BiergitKraft/RAMPS-FD/README.md

# RAMPS-FD

RAMPS for Due.

A RAMPS style Shield for Arduino Due to benefit from the 32bit uC combined with the modular Design of a RAMPS Board.
V2.3 adds SPI support by simply selecting it with a few jumpers.
V3.0 adds UART support. WIP

Status
-------

V2.3 tested and fuctional.
V3.0 WIP
