BiergitKraft/RAMPS-FD/RAMPS-FD/Docs/RAMPS-FD_bom_v2_3.ods

Component | Description | Part | References | Value | Footprint | Quantity Per PCB | Datasheet | Fitted | Ordering | Price (USD) | Rating | Values | Populate | DriverReference
1 | C0603_100n | 100n | C3 C4 C8 C12 C13 C14 C16 C18 C20 | 100n | C_0603 | 9 |  | yes | LCSC: C85999 | 0,016915 | #100nF #50V #5%
2 | 100uF 35V Elko SMD 6,3x7,7mm | 100u_35V | C2 C5 C6 C7 C9 C10 C11 | 100u_35V | CP_Elec_6.3x7.7 | 7 |  | yes | LCSC: C88675 | 0,067122 | #100uF #35V #20%
3 | C0603_10u | 10u | C15 C17 C19 C21 | 10u | C_0603 | 4 |  | yes | LCSC: C96446 | 0,043979 | #10uF #25V #10%
4 | 1kV 1A General Purpose Diode, SOD-123 | 2CZ4007 | D12 D28 D30 | 2CZ4007 | D_SOD-123F | 3 | https://datasheet.lcsc.com/szlcsc/1809132226_Changjiang-Electronics-Tech-CJ-2CZ4007_C85712.pdf | yes | LCSC: C85712 | 0,05 | #1kV #1A
5 | Schottky Barrier Diode | DS110W | D6 D8 D10 D14 D16 D18 | DS110W | D_SOD-123F | 6 | https://datasheet.lcsc.com/szlcsc/1805300419_Shandong-Jingdao-Microelectronics-DS110W_C123900.pdf | yes | LCSC: C169527 | 0,084347 |  | #100V #1A #850mV
6 | Zener diode | KDZVTR11B | D3 D4 | KDZVTR11B | D_SOD-123F | 2 |  | yes | LCSC: C209598 | 0,09
7 | 530nm GREEN-LED, 0603 | LED_0603_GREEN | D2 D13 | LED_0603_GREEN | LED_0603 | 2 | https://datasheet.lcsc.com/szlcsc/1811141223_TOGIALED-TJ-S1608SW6TGLC2G-A5_C192316.pdf | yes | LCSC: C192316 | 0,021656
8 | 625nm RED-LED, 0603 | LED_0603_RED | D22 D23 D26 D27 D29 D31 | LED_0603_RED | LED_0603 | 6 | https://datasheet.lcsc.com/szlcsc/1811141223_TOGIALED-TJ-S1608SW6TGLC2R-A5_C192315.pdf | yes | LCSC: C192315 | 0,018284
9 | 300V 1A General Purpose Diode, SMA | MRA4003T3G | D5 D20 D21 D24 D25 | MRA4003T3G | D_SMA | 5 | https://www.onsemi.com/pub/Collateral/MRA4003T3-D.PDF | yes | LCSC: C94410 | 0,049228 | #300V #1A
10 | TVS diode | SMF36CA | D7 D9 D11 D15 D17 D19 | SMF36CA | D_SOD-123F | 6 |  | yes | LCSC: C353285 | 0,02
11 | SMD Fuse 750mA Fast | FUSE_750mA_0603 | F5 F6 | FUSE_750mA_0603 | R_0603 | 2 |  | Fitted | LCSC: C310926 | 0,07 | #32V #750mA
12 | Blade Fuse Holder for Car Fuses | Keystone_3568 | F2 F3 F4 | Keystone_3568 | Fuseholder_Blade_Mini_Keystone_3568 | 3 |  | yes | Digikey: 36-3568-ND | 1,03 | #500V #30A
13 | Ferrite Bed 0603 | FB0603 | FB2 | FB0603 | R_0603 | 1 | ~ | yes | LCSC: C441755 | 0,032936 | #500mA #390Ohm@100MHz
14 |  | 1x18PinHeader | J24 | 1x18PinHeader | PinHeader_1x18_P2.54mm_Vertical | 1 |  | yes | LCSC: 1xC124381 1xC124372 | 0,095805
15 |  | 1x3JumperArray | J5 J7 | 1x3JumperArray | PinHeader_1x03_P2.54mm_Vertical | 2 |  | yes | LCSC: C49257 | 0,010025
16 |  | 1x3PinHeader | J8 J17 J20 | 1x3PinHeader | PinHeader_1x03_P2.54mm_Vertical | 3 |  | yes | LCSC: C49257 | 0,010025
17 |  | 1x4PinHeader | J9 J10 J11 J12 J14 J15 J16 J19 J22 | 1x4PinHeader | pin_header_2.54mm_1x4 | 9 |  | yes | LCSC: C124378 | 0,024235
18 | 2 Circuit Screw Terminal P3.50 | 2_PinScrewTerminal_P350 | J25 J27 J28 | 2_PinScrewTerminal_P350 | 2x1_P350 | 3 |  | yes | LCSC: C474892 | 0,07
19 | 2 Circuit Screw Terminal P5.08 | 2_PinScrewTerminal_P508 | J26 | 2_PinScrewTerminal_P508 | 2x1_P508 | 1 |  | yes | LCSC: C474952 | 0,13895
20 |  | 2x1PinHeader | J2 J6 J13 J30 J31 | 2x1PinHeader | PinHeader_1x02_P2.54mm_Vertical | 5 |  | yes | LCSC: C124375 | 0,015147
21 | 2x4 Pin Header 2.54mm | 2x4PinHeader_2.54mm | J32 | 2x4PinHeader_2.54mm | pin_header_2.54mm_2x4 | 1 |  | yes | LCSC: C124386 | 0,039494
22 |  | 2x5PinHeader | J18 | 2x5PinHeader | pin_header_2.54mm_2x5 | 1 |  | yes | LCSC: C124387 | 0,04557
23 |  | 2x6PinHeader | J21 | 2x6PinHeader | pin_header_2.54mm_2x6 | 1 |  | yes | LCSC: C124388 | 0,057859
24 |  | 3x4PinHeader | J23 | 3x4PinHeader | 4x3_2.54mm_Header | 1 |  | yes | LCSC: 1x C124386 1xC124378 | 0,063729
25 |  | 3x6PinHeader | J29 | 3x6PinHeader | 6x3_2.54mm_Header | 1 |  | yes | LCSC: 3xC190819 | 0,07
26 | 6 Circuit Screw Terminal P5.08 | 6_PinScrewPlugableTerminal_P508 | J3 | 6_PinScrewPlugableTerminal_P508 | 6x1_P508_RA | 1 |  | yes | LCSC: 1xC71374 1xC8435 | 0,427717
27 |  | NetTie_1mm | J4 | NetTie_1mm | TIE-1MM | 1 |  |  |  |  |  |  | No
28 | Generic connector, single row, 01x02, script generated (kicad-library-utils/schlib/autogen/connector/) | 1x2JumperArray | JP2 JP3 JP5 JP7 JP9 JP11 JP13 JP15 JP16 | 1x2JumperArray | PinHeader_1x02_P2.54mm_Vertical | 9 | ~ | yes | LCSC: C124375 | 0,015147
29 |  | 4x3JumperArray | JP4 JP6 JP8 JP10 JP12 JP14 | 4x3JumperArray | 4x3_2.54mm_Header | 6 |  | yes | LCSC: 1x C124386 1xC124378 | 0,063729
30 |  | LOGO_OSHW | M2 | LOGO_OSHW | OSHW_logo_2 | 1 |  |  |  |  |  |  | No
31 | N Channel MOSFET | NCE3416 | Q2 Q5 Q10 Q11 | NCE3416 | SOT-23 | 4 | https://datasheet.lcsc.com/szlcsc/1811071721_Wuxi-NCE-Power-Semiconductor-NCE3416_C113491.pdf | yes | LCSC: C113491 | 0,033091 | #20V #6.5A
32 | N Channel Power MOSFET | PSMN1R8-40YLC | Q7 | PSMN1R8-40YLC | LFPAK56 | 1 | https://assets.nexperia.com/documents/data-sheet/PSMN1R8-40YLC.pdf | yes | LCSC: C124522 | 0,281273 | #40V #100A
33 | N Channel Power MOSFET | PSMN7R5-60YLX | Q6 Q8 Q9 | PSMN7R5-60YLX | LFPAK56 | 3 | https://assets.nexperia.com/documents/data-sheet/PSMN1R8-40YLC.pdf | yes | LCSC: C478175 | 0,972045 | #60V #86A
34 | -17A Id, -30V Vds, P-Channel MOSFET, SO 8 | TDM3415 | Q3 Q4 | TDM3415 | SO-8_3.9x4.9mm_P1.27mm | 2 | https://datasheet.lcsc.com/szlcsc/1912111437_APEC-Advanced-Power-Elec-AP4439GM_C429862.pdf | yes | LCSC: C189490 | 0,26
35 | R0603_100k | 100k | R7 R9 R11 R12 R17 R19 R21 | 100k | R_0603 | 7 |  | yes | LCSC: C237792 | 0,003527
36 | R0603_10k | 10k | R3 R4 R6 R8 R10 R16 R18 R20 R22 R23 R24 R25 | 10k | R_0603 | 12 |  | yes | LCSC: C238881 | 0,003395
37 | R0603_1k0 | 1k | R5 R15 R26 R27 R30 R31 R34 R36 R38 R39 R40 R41 | 1k | R_0603 | 12 |  | yes | LCSC: C328340 | 0,003087
38 | R0603_330R | 330R | R2 R14 | 330R | R_0603 | 2 |  | yes | LCSC: C144606 | 0,002275
39 | R0603_33R | 33R | R28 R29 R32 R33 R35 R37 | 33R | R_0603 | 6 |  | yes | LCSC: C325638 | 0,002066
40 | R0603_4k7 | 4k7 | R13 | 4k7 | R_0603 | 1 |  | yes | LCSC: C137710 | 0,002446
41 | 10k 0603 x4 Array | 10kArrayx4 | RP2 RP3 RP4 RP5 RP6 | 10kArrayx4 | R_Array_Convex_4x0603 | 5 |  | yes | LCSC: C29718 | 0,007304
42 |  | ARDUINO_DUE_SHIELD | SHIELD2 | ARDUINO_DUE_SHIELD | ARDUINO_MEGA_DUE_SHIELD_FOOTPRINT_RMC | 1 |  | yes | LCSC: 1xC124372 5xC124381 1xC168945
43 |  | PushButton | SW2 | PushButton | SW_6x6_SMD | 1 |  | yes | LCSC: C273496 | 0,497955
44 | Non-Volatile 512Kb (64K x 8) I2C EEPROM | 24C512 | U10 | 24C512 | SOIC-8_3.9x4.9mm_P1.27mm | 1 |  | yes | LCSC: C79986 | 0,295782
45 | Fixed 32V 12V 1A TO-252-2(DPAK) Linear Voltage Regulator | AS7812ADTR | U2 | AS7812ADTR | TO-252-2 | 1 |  | yes | LCSC: C248312 | 0,203382 | #12V #35V #1A
46 | Low Voltage Hex Buffer with Open Drain Outputs | MC74LCX07 | U11 | MC74LCX07 | TSSOP-14_4.4x5mm_P0.65mm | 1 | https://www.onsemi.com/pub/Collateral/MC74LCX07-D.PDF | yes | LCSC: C233625 | 0,171882
47 | Header for Motor Driver | Pololu | U3 U4 U5 U7 U8 U9 | Pololu | POLOLU | 6 |  | yes | LCSC: 2x C27438 | 0,102 |  |  |  | ?
48 | Single Power Supply Single Buffer Gate | SN74LV1T125 | U6 | SN74LV1T125 | SOT-23-5 | 1 | https://www.ti.com/lit/ds/symlink/sn74lv1t125.pdf | yes | LCSC: C473338 | 0,268864
49 | R0603_33V | 33V | VR2 VR3 VR4 VR5 VR6 VR7 VR8 VR9 VR10 VR11 VR12 VR13 VR14 VR15 VR16 VR17 VR18 VR19 VR20 VR21 VR22 VR23 VR24 VR25 VR26 VR27 VR28 VR29 VR30 VR31 VR32 VR33 VR34 VR35 VR36 VR37 | 33V | R_0603 | 36 |  | yes | LCSC: C336820 | 0,08
 |  |  |  |  |  |  |  |  |  | 5,932273
Component Groups: | 49
Component Count: | 206
Fitted Components: | 206
Number of PCBs: | 1
Total components: | 206
Schematic Version: | v2.3
Schematic Date: | 2019-04-13
PCB Variant: | ['default']
BoM Date: | Di 26 Mai 2020 21:52:22 CEST
Schematic Source: | RAMPS-FD.sch
KiCad Version: | Eeschema 5.1.5
