BiergitKraft/RAMPS-FD/RAMPS-FD/Docs/Bestückungsdruck.pdf

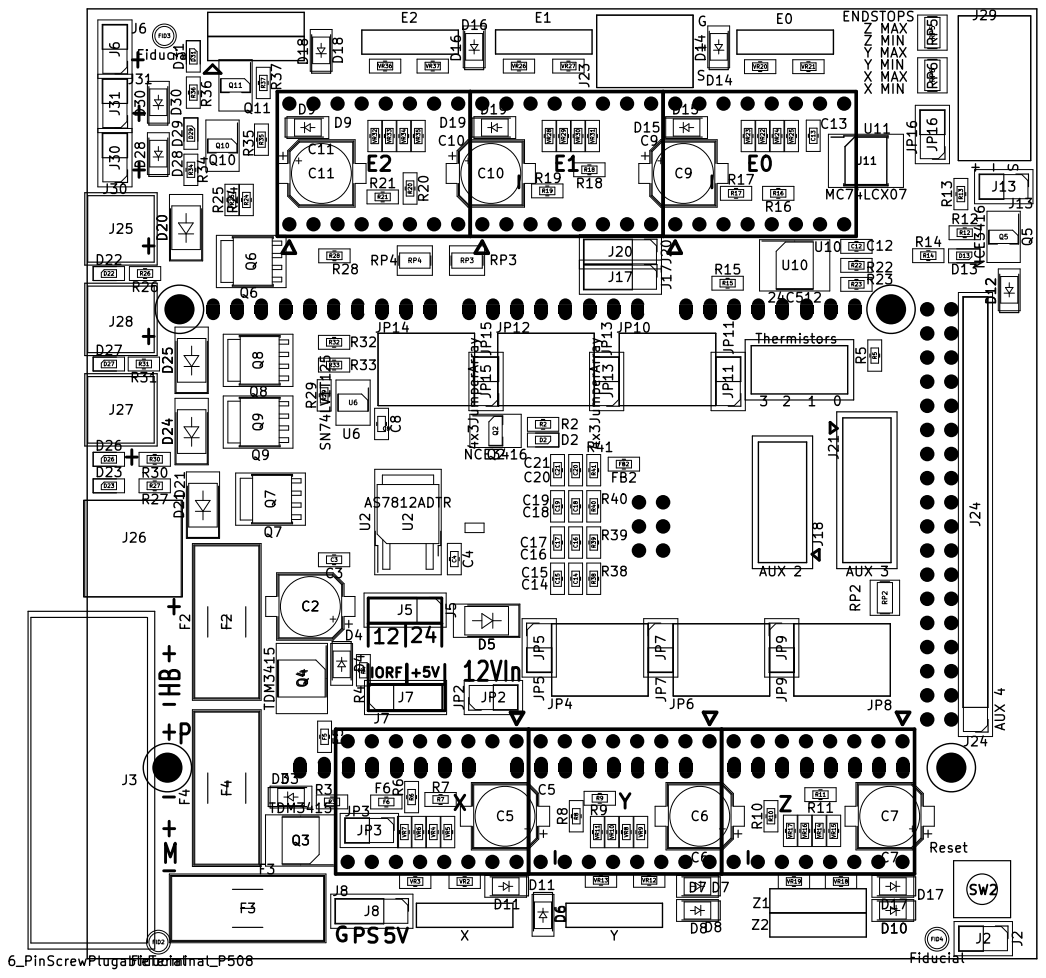
[picture p2: page 1]
