BiergitKraft/RAMPS-FD/RAMPS-FD/RAMPS-FD-gerbers/RAMPS-FD-F_Fab.pdf

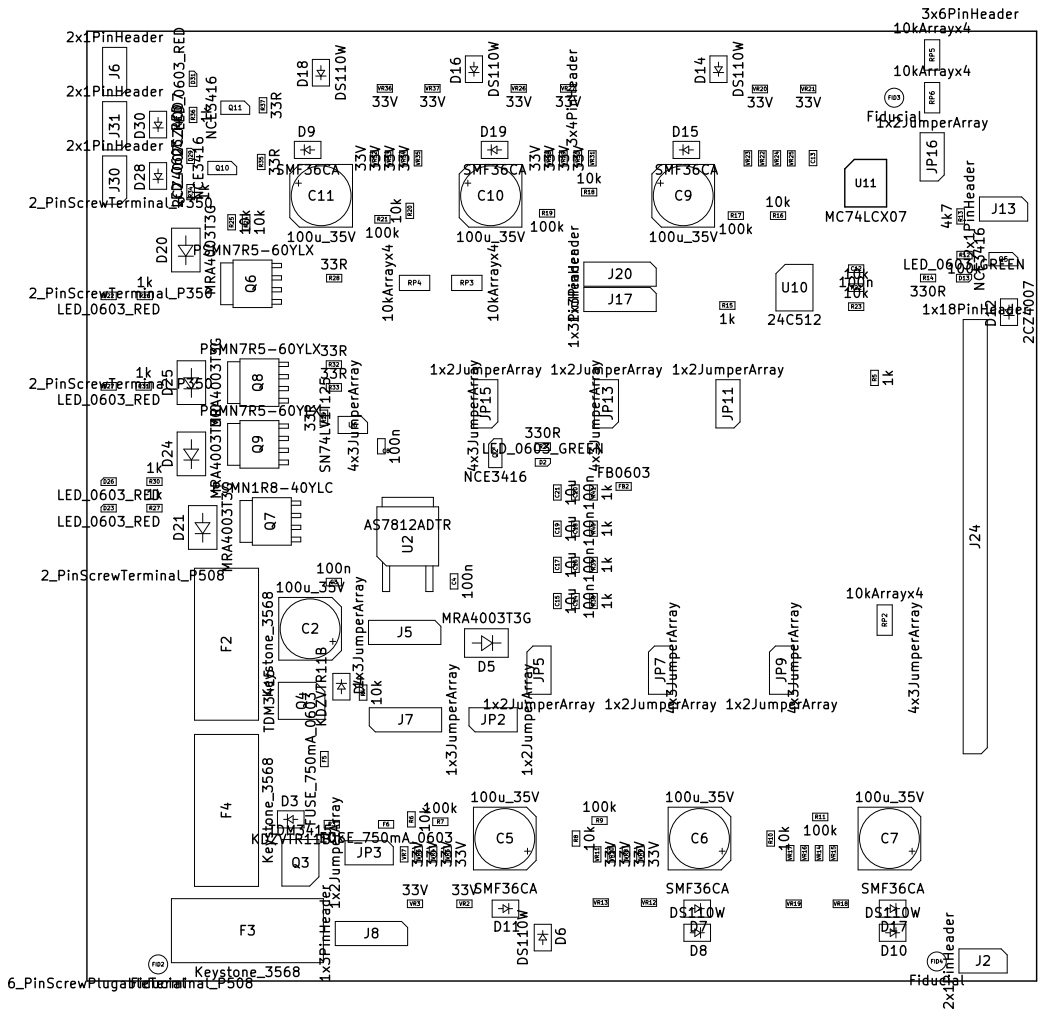
[picture p13: page 1]
