BiergitKraft/RAMPS-FD/RAMPS-FD/RAMPS-FD-gerbers/Bestückplan.pdf

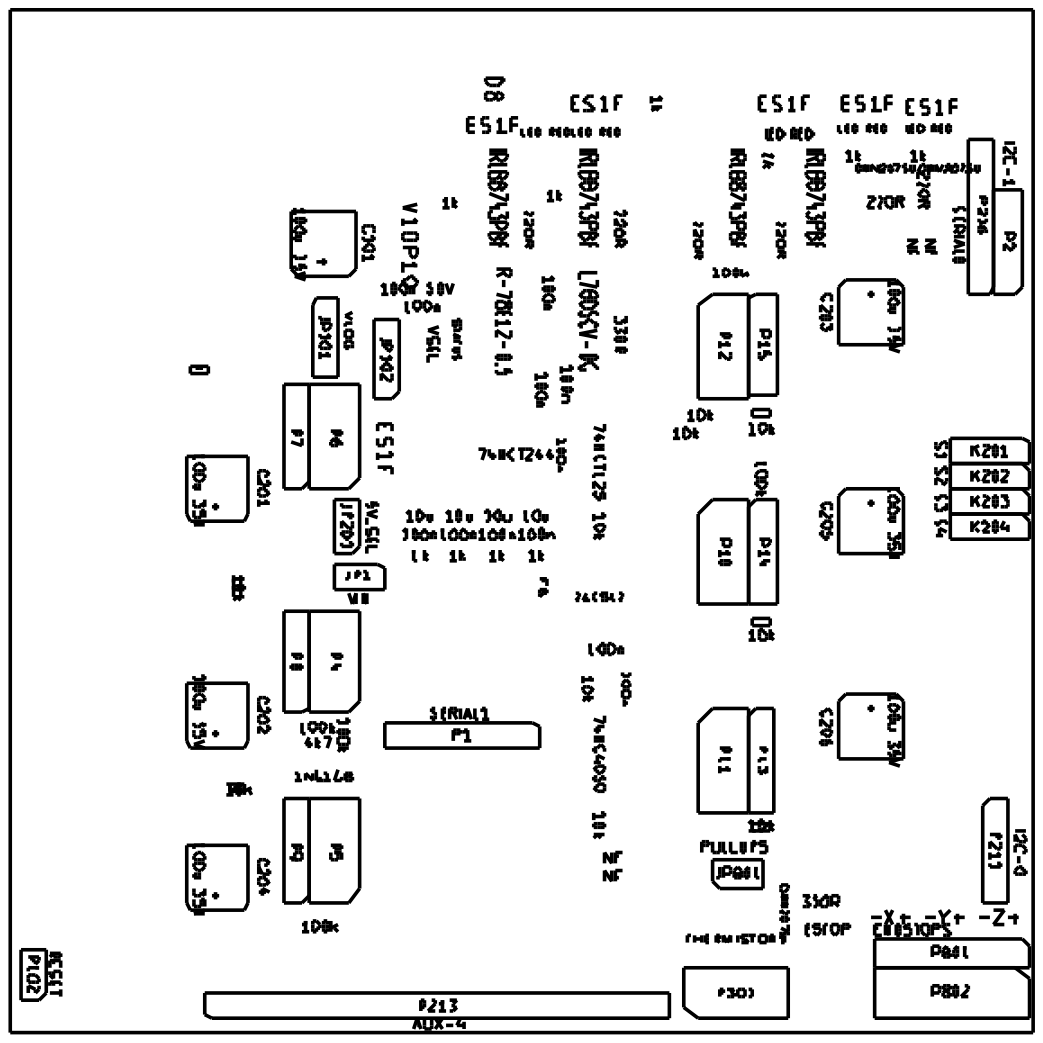
[picture p14: page 1]

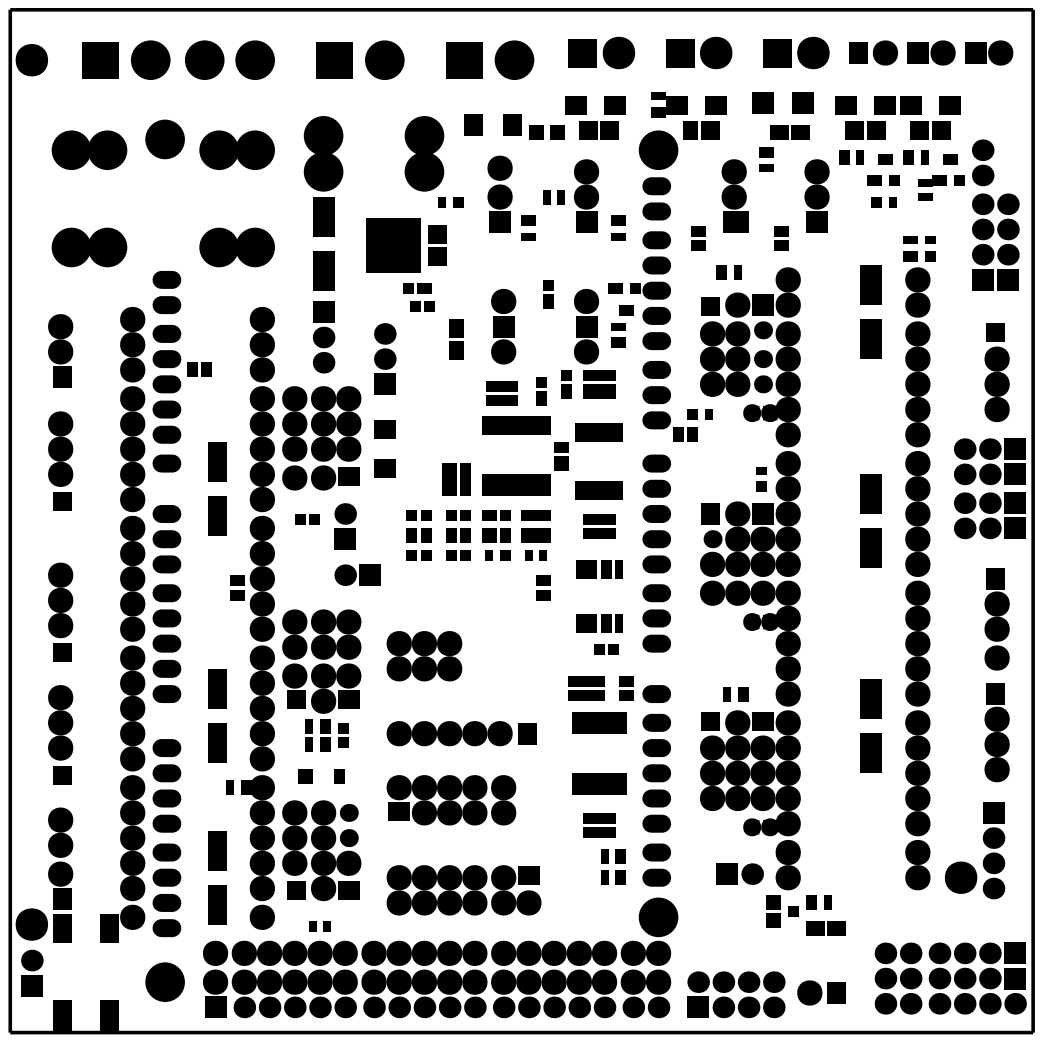
[picture p15: page 2]
