BiergitKraft/RAMPS-FD/RAMPS-FD/RAMPS-FD.kicad_pcb

## KiCad design RAMPS-FD/RAMPS-FD.kicad_pcb (2020-08-26)

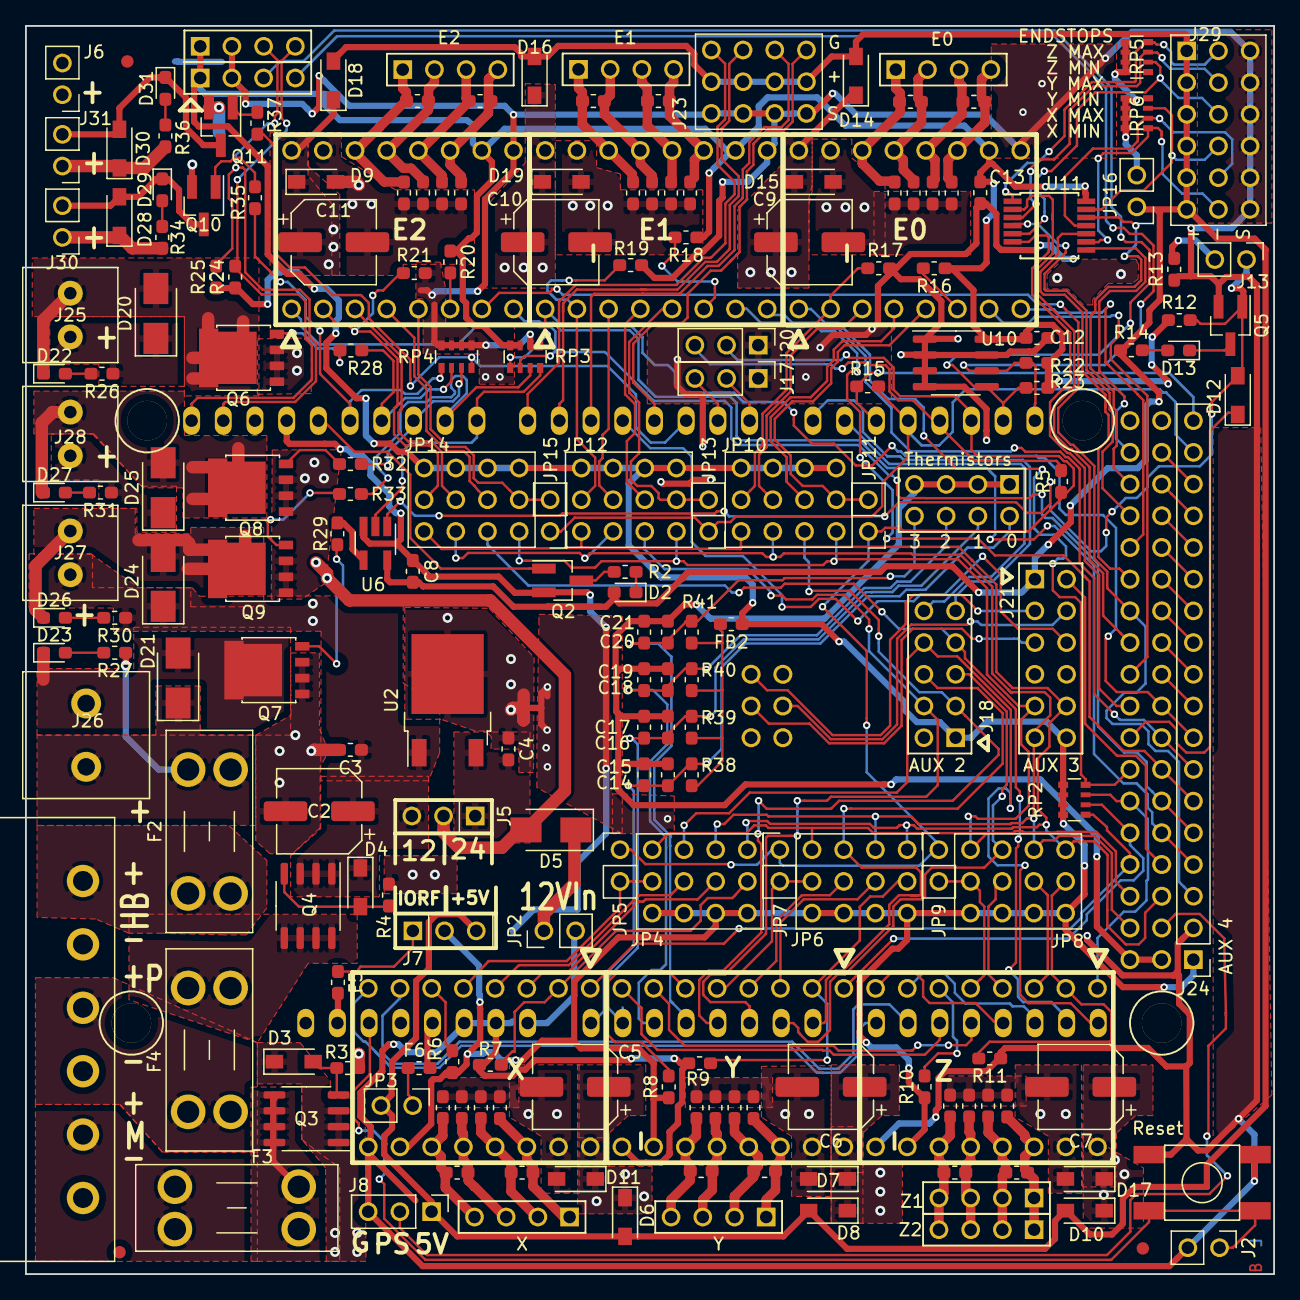
[picture p16: board RAMPS-FD.kicad_pcb from above]

Board: 2 copper layers, 100.0 x 100.0 mm, 209 parts (1 on the bottom side), 186 nets.

Parts:
C2, C5, C6, C7, C9, C10, C11: 100u_35V; CP_Elec_6.3x7.7
C3, C4, C8, C12, C13, C14, C16, C18, C20: 100n; C_0603
C15, C17, C19, C21: 10u; C_0603
D2, D13: LED_0603_GREEN; LED_0603
D3, D4: KDZVTR11B; D_SOD-123F
D5, D20, D21, D24, D25: MRA4003T3G; D_SMA
D6, D8, D10, D14, D16, D18: DS110W; D_SOD-123F
D7, D9, D11, D15, D17, D19: SMF36CA; D_SOD-123F
D12, D28, D30: 2CZ4007; D_SOD-123F
D22, D23, D26, D27, D29, D31: LED_0603_RED; LED_0603
F2, F3, F4: Keystone_3568; Fuseholder_Blade_Mini_Keystone_3568
F5, F6: FUSE_750mA_0603; R_0603
FB2: FB0603; R_0603
FID2, FID3, FID4: Fiducial; Fiducial_1mm_Mask2mm
J2, J6, J13, J30, J31: 2x1PinHeader; PinHeader_1x02_P2.54mm_Vertical
J3: 6_PinScrewPlugableTerminal_P508; 6x1_P508_RA
J5, J7: 1x3JumperArray; PinHeader_1x03_P2.54mm_Vertical
J8, J17, J20: 1x3PinHeader; PinHeader_1x03_P2.54mm_Vertical
J9, J10, J11, J12, J14, J15, J16, J19, J22: 1x4PinHeader; pin_header_2.54mm_1x4
J18: 2x5PinHeader; pin_header_2.54mm_2x5
J21: 2x6PinHeader; pin_header_2.54mm_2x6
J23: 3x4PinHeader; 4x3_2.54mm_Header
J24: 1x18PinHeader; PinHeader_1x18_P2.54mm_Vertical
J25, J27, J28: 2_PinScrewTerminal_P350; 2x1_P350
J26: 2_PinScrewTerminal_P508; 2x1_P508
J29: 3x6PinHeader; 6x3_2.54mm_Header
J32: 2x4PinHeader_2.54mm; pin_header_2.54mm_2x4
JP2, JP3, JP5, JP7, JP9, JP11, JP13, JP15, JP16: 1x2JumperArray; PinHeader_1x02_P2.54mm_Vertical
JP4, JP6, JP8, JP10, JP12, JP14: 4x3JumperArray; 4x3_2.54mm_Header
M2: LOGO_OSHW; OSHW_logo_2
NT1: NetTie-2_SMD_Pad0.5mm
Q2, Q5, Q10, Q11: NCE3416; SOT-23
Q3, Q4: TDM3415; SO-8_3.9x4.9mm_P1.27mm
Q6, Q8, Q9: PSMN7R5-60YLX; LFPAK56
Q7: PSMN1R8-40YLC; LFPAK56
R2, R14: 330R; R_0603
R3, R4, R6, R8, R10, R16, R18, R20, R22, R23, R24, R25: 10k; R_0603
R5, R15, R26, R27, R30, R31, R34, R36, R38, R39, R40, R41: 1k; R_0603
R7, R9, R11, R12, R17, R19, R21: 100k; R_0603
R13: 4k7; R_0603
R28, R29, R32, R33, R35, R37: 33R; R_0603
RP2, RP3, RP4, RP5, RP6: 10kArrayx4; R_Array_Convex_4x0603
SHIELD2: ARDUINO_DUE_SHIELD; ARDUINO_MEGA_DUE_SHIELD_FOOTPRINT_RMC
SW2: PushButton; SW_6x6_SMD
U2: AS7812ADTR; TO-252-2
U3, U4, U5, U7, U8, U9: Pololu; POLOLU
U6: SN74LV1T125; SOT-23-5
U10: 24C512; SOIC-8_3.9x4.9mm_P1.27mm
U11: MC74LCX07; TSSOP-14_4.4x5mm_P0.65mm
VR2, VR3, VR4, VR5, VR6, VR7, VR8, VR9, VR10, VR11, VR12, VR13, VR14, VR15, VR16, VR17, VR18, VR19, VR20, VR21, VR22, VR23, VR24, VR25, VR26, VR27, VR28, VR29, VR30, VR31, VR32, VR33, VR34, VR35, VR36, VR37: 33V; R_0603

Connections:
+5V: C8.1, D2.2, D6.2, D8.2, D10.2, D14.2, D16.2, D18.2, J7.3, J8.1, J21.1, J23.2, J23.5, J23.8, J23.11, J29.1, J29.4, J29.7, J29.10, J29.13, J29.16, JP3.2, JP16.1, R14.1, U6.5
+12P: D5.2, D28.1, D30.1, J5.2, J6.1, J30.1, J31.1, R34.1, R36.1
+V_HEATBED: D21.1, F2.2, J26.1, R27.1
+V_LOGIC: C12.1, C13.1, FB2.1, J7.2, J18.1, J19.1, J21.12, J22.1, J24.1, JP4.3, JP4.6, JP4.9, JP4.12, JP6.3, JP6.6, JP6.9, JP6.12, JP8.3, JP8.6, JP8.9, JP8.12, JP10.3, JP10.6, JP10.9, JP10.12, JP12.3, JP12.6, JP12.9, JP12.12, JP14.3, JP14.6, JP14.9, JP14.12, R6.1, R8.1, R10.1, R12.1, R16.1, R18.1, R20.1, R22.1, R23.1, R24.1, R25.1, RP2.5, RP2.6, RP2.7, RP2.8, RP3.7, RP3.8, U3.10, U4.10, U5.10, U7.10, U8.10, U9.10, U10.8, U11.14
+V_MOTOR: C5.1, C6.1, C7.1, C9.1, C10.1, C11.1, D3.1, D6.1, D7.1, D8.1, D9.1, D10.1, D11.1, D14.1, D15.1, D16.1, D17.1, D18.1, D19.1, Q3.1, Q3.2, Q3.3, U3.16, U4.16, U5.16, U7.16, U8.16, U9.16
+V_POWER: C2.1, C3.1, D4.1, D20.1, D24.1, D25.1, J5.3, J25.1, J27.1, J28.1, Q4.1, Q4.2, Q4.3, R26.1, R30.1, R31.1, U2.1
/E0_EN_BUF: RP2.4, SHIELD2.42, U7.1
/E1_EN_BUF: J24.8, RP3.1, SHIELD2.39, U8.1
/E2_EN_BUF: J24.5, RP3.2, SHIELD2.45, U9.1
/Extra MOSFETs/P_FET5: D28.2, D29.1, J30.2, Q10.3
/Extra MOSFETs/P_FET6: D30.2, D31.1, J31.2, Q11.3
/Mosfet Outputs/D8_OUT: D21.2, D23.1, J26.2, Q7.5
/Mosfet Outputs/D9_OUT: D24.2, D26.1, J27.2, Q9.5
/Mosfet Outputs/D10_OUT: D25.2, D27.1, J28.2, Q8.5
/Mosfet Outputs/FET4_OUT: D20.2, D22.1, J25.2, Q6.5
/Power/HB_IN: F2.1, J3.1
/Power/LP_1: D5.1, JP2.1
/Power/LP_2: C4.1, J5.1, U2.3
/Power/MOT_IN: F3.1, J3.5
/Power/P_IN: F4.1, J3.3
/RESET: J2.1, SHIELD2.RST, SW2.1
/Stepper Drivers 2/E0-1A: J14.3, U7.12, VR21.1, VR24.1
/Stepper Drivers 2/E0-1B: J14.4, U7.11, VR21.2, VR25.1
/Stepper Drivers 2/E0-2A: J14.2, U7.13, VR20.2, VR22.1
/Stepper Drivers 2/E0-2B: J14.1, U7.14, VR20.1, VR23.1
/Stepper Drivers 2/E1-1A: J15.3, U8.12, VR27.1, VR30.1
/Stepper Drivers 2/E1-1B: J15.4, U8.11, VR27.2, VR31.1
/Stepper Drivers 2/E1-2A: J15.2, U8.13, VR26.2, VR29.1
/Stepper Drivers 2/E1-2B: J15.1, U8.14, VR26.1, VR28.1
/Stepper Drivers 2/E2-1A: J16.3, U9.12, VR34.1, VR37.1
/Stepper Drivers 2/E2-1B: J16.4, U9.11, VR35.1, VR37.2
/Stepper Drivers 2/E2-2A: J16.2, U9.13, VR33.1, VR36.2
/Stepper Drivers 2/E2-2B: J16.1, U9.14, VR32.1, VR36.1
/Stepper Drivers/X-1A: J9.3, U3.12, VR3.1, VR6.1
/Stepper Drivers/X-1B: J9.4, U3.11, VR3.2, VR7.1
/Stepper Drivers/X-2A: J9.2, U3.13, VR2.2, VR4.1
/Stepper Drivers/X-2B: J9.1, U3.14, VR2.1, VR5.1
/Stepper Drivers/Y-1A: J10.3, U4.12, VR10.1, VR13.1
/Stepper Drivers/Y-1B: J10.4, U4.11, VR11.1, VR13.2
/Stepper Drivers/Y-2A: J10.2, U4.13, VR8.1, VR12.2
/Stepper Drivers/Y-2B: J10.1, U4.14, VR9.1, VR12.1
/Stepper Drivers/Z-1A: J11.3, J12.3, U5.12, VR16.1, VR19.1
/Stepper Drivers/Z-1B: J11.4, J12.4, U5.11, VR17.1, VR19.2
/Stepper Drivers/Z-2A: J11.2, J12.2, U5.13, VR14.1, VR18.2
/Stepper Drivers/Z-2B: J11.1, J12.1, U5.14, VR15.1, VR18.1
/X_EN_BUF: RP2.1, SHIELD2.48, U3.1
/Y_EN_BUF: RP2.2, SHIELD2.46, U4.1
/Z_EN_BUF: RP2.3, SHIELD2.44, U5.1
A4: J18.3, JP10.7, SHIELD2.AD4
A5: J18.4, JP12.7, SHIELD2.AD5
A6: J18.5, JP8.7, SHIELD2.AD6
A7: J18.6, JP6.7, SHIELD2.AD7
AD14: J18.7, JP14.7, SHIELD2.AD14
AD15: J18.8, JP4.7, SHIELD2.AD15
AM-VIN: JP2.2, SHIELD2.V_IN
AREF: FB2.2, R38.1, R39.1, R40.1, R41.1
D2-FET6: R37.1, RP4.8, SHIELD2.2
D8: RP3.4, SHIELD2.8, U6.2
D8_BUF: R29.1, U6.4
D9: R33.1, RP3.3, SHIELD2.9
D10: R32.1, RP4.7, SHIELD2.10
D11-FET4: R28.1, RP4.6, SHIELD2.11
D12-FET5: R35.1, RP4.5, SHIELD2.12
D13: Q2.1, SHIELD2.13
D23: J24.16, SHIELD2.23
D25: J24.15, SHIELD2.25
D27: J24.14, SHIELD2.27
D29: J24.13, SHIELD2.29
D31: J24.12, SHIELD2.31
D32: J24.3, SHIELD2.32, U9.7
D33: J24.11, SHIELD2.33
D35: J24.10, SHIELD2.35
D37: J24.9, SHIELD2.37
D41: J24.7, SHIELD2.41, U8.8
D43: J24.6, SHIELD2.43, U8.7
D47: J24.4, SHIELD2.47, U9.8
D49: J21.2, SHIELD2.49
D50-MISO: J21.9, JP4.10, JP6.10, JP8.10, JP10.10, JP12.10, JP14.10, SHIELD2.50
D51-MOSI: J21.10, JP4.1, JP6.1, JP8.1, JP10.1, JP12.1, JP14.1, SHIELD2.51
D52-SCK: J21.11, JP4.4, JP6.4, JP8.4, JP10.4, JP12.4, JP14.4, SHIELD2.52
DUE_5V: F6.2, SHIELD2.5V
E0_DIR: SHIELD2.28, U7.8
E0_STEP: SHIELD2.36, U7.7
ESTOP: D12.1, SHIELD2.40
GND: C8.2, C12.2, C13.2, J2.2, J6.2, J8.3, J17.1, J18.2, J19.2, J20.1, J21.7, J22.2, J23.1, J23.4, J23.7, J23.10, J24.2, J29.3, J29.6, J29.9, J29.12, J29.15, J29.18, NT1.2, Q2.2, Q5.2, R7.2, R9.2, R11.2, R13.2, R17.2, R19.2, R21.2, RP3.5, RP3.6, RP4.1, RP4.2, RP4.3, RP4.4, SHIELD2.GND, SHIELD2.GND6, SW2.2, U3.9, U4.9, U5.9, U6.3, U7.9, U8.9, U9.9, U10.1, U10.2, U10.3, U10.4, U10.7, U11.7
GNDA: C14.2, C15.2, C16.2, C17.2, C18.2, C19.2, C20.2, C21.2, J32.1, J32.3, J32.5, J32.7, SHIELD2.GND4, SHIELD2.GND5
IOREF: F5.2, SHIELD2.IORF
MISO: J21.3, SHIELD2.MISO
MOSI: J21.4, SHIELD2.MOSI
MOT_GND: C2.2, C3.2, C4.2, C5.2, C6.2, C7.2, C9.2, C10.2, C11.2, D7.2, D9.2, D11.2, D15.2, D17.2, D19.2, J3.2, J3.4, J3.6, NT1.1, Q6.1, Q6.2, Q6.3, Q7.1, Q7.2, Q7.3, Q8.1, Q8.2, Q8.3, Q9.1, Q9.2, Q9.3, Q10.2, Q11.2, R3.2, R4.2, U2.2, U3.15, U4.15, U5.15, U7.15, U8.15, U9.15, VR4.2, VR5.2, VR6.2, VR7.2, VR8.2, VR9.2, VR10.2, VR11.2, VR14.2, VR15.2, VR16.2, VR17.2, VR22.2, VR23.2, VR24.2, VR25.2, VR28.2, VR29.2, VR30.2, VR31.2, VR32.2, VR33.2, VR34.2, VR35.2
unnamed: D2.1, R2.1
unnamed: D3.2, Q3.4, R3.1
unnamed: D4.2, Q4.4, R4.1
unnamed: D12.2, J13.1, Q5.1, R12.2, U6.1
unnamed: D13.1, Q5.3
unnamed: D13.2, R14.2
unnamed: D22.2, R26.2
unnamed: D23.2, R27.2
unnamed: D26.2, R30.2
unnamed: D27.2, R31.2
unnamed: D29.2, R34.2
unnamed: D31.2, R36.2
unnamed: F3.2, Q3.5, Q3.6, Q3.7, Q3.8
unnamed: F4.2, Q4.5, Q4.6, Q4.7, Q4.8
unnamed: F5.1, J7.1
unnamed: F6.1, JP3.1
unnamed: J13.2, R13.1
unnamed: J29.2, RP5.4, U11.1
unnamed: J29.5, RP5.3, U11.3
unnamed: J29.8, RP5.2, U11.5
unnamed: J29.11, RP6.3, U11.13
unnamed: J29.14, RP6.2, U11.11
unnamed: J29.17, RP6.1, U11.9
unnamed: JP4.2, R7.1, U3.2
unnamed: JP4.5, U3.3
unnamed: JP4.8, U3.4
unnamed: JP4.11, JP5.2, U3.5
unnamed: JP6.2, R9.1, U4.2
unnamed: JP6.5, U4.3
unnamed: JP6.8, U4.4
unnamed: JP6.11, JP7.2, U4.5
unnamed: JP8.2, R11.1, U5.2
unnamed: JP8.5, U5.3
unnamed: JP8.8, U5.4
unnamed: JP8.11, JP9.2, U5.5
unnamed: JP10.2, R17.1, U7.2
unnamed: JP10.5, U7.3
unnamed: JP10.8, U7.4
unnamed: JP10.11, JP11.2, U7.5
unnamed: JP12.2, R19.1, U8.2
unnamed: JP12.5, U8.3
unnamed: JP12.8, U8.4
unnamed: JP12.11, JP13.2, U8.5
unnamed: JP14.2, R21.1, U9.2
unnamed: JP14.5, U9.3
unnamed: JP14.8, U9.4
unnamed: JP14.11, JP15.2, U9.5
unnamed: JP16.2, RP5.5, RP5.6, RP5.7, RP5.8, RP6.5, RP6.6, RP6.7, RP6.8
unnamed: Q2.3, R2.2
unnamed: Q6.4, R28.2
unnamed: Q7.4, R29.2
unnamed: Q8.4, R32.2
unnamed: Q9.4, R33.2
unnamed: Q10.1, R35.2
unnamed: Q11.1, R37.2
unnamed: R6.2, U3.6
unnamed: R8.2, U4.6
unnamed: R10.2, U5.6
unnamed: R16.2, U7.6
unnamed: R18.2, U8.6
unnamed: R20.2, U9.6
PS-ON: J8.2, SHIELD2.53
SCK: J21.5, SHIELD2.SCK
SCL: J19.4, R22.2, SHIELD2.21, U10.6
SCL1: J22.4, R24.2, SHIELD2.SCL1
SDA: J19.3, R23.2, SHIELD2.20, U10.5
SDA1: J22.3, R25.2, SHIELD2.SDA1
SERVO1: J23.3, SHIELD2.7
SERVO2: J23.6, SHIELD2.6
SERVO3: J23.9, SHIELD2.5
SERVO4: J23.12, SHIELD2.3
SPI_CS1: J21.6, SHIELD2.4
THERM0: C14.1, C15.1, J32.2, R38.2, SHIELD2.AD0
THERM1: C16.1, C17.1, J32.4, R39.2, SHIELD2.AD1
THERM2: C18.1, C19.1, J32.6, R40.2, SHIELD2.AD2
THERM3: C20.1, C21.1, J32.8, R41.2, SHIELD2.AD3
UART0_RX_LV: J17.2, SHIELD2.0
UART0_TX_LV: J17.3, SHIELD2.1
UART1_RX_LV: J20.2, JP5.1, JP7.1, JP9.1, JP11.1, R5.1, SHIELD2.19
UART1_TX_LV: J20.3, R5.2, SHIELD2.18
UART2_RX_LV: J24.17, JP13.1, JP15.1, R15.2, SHIELD2.17
UART2_TX_LV: J24.18, R15.1, SHIELD2.16
UART3_RX_LV: J18.10, SHIELD2.15
UART3_TX_LV: J18.9, SHIELD2.14
X-MAX: SHIELD2.30, U11.10
X-MIN: SHIELD2.22, U11.8
X_DIR: SHIELD2.AD8, U3.8
X_STEP: SHIELD2.AD9, U3.7
Y-MAX: SHIELD2.38, U11.6
Y-MIN: SHIELD2.24, U11.12
Y_DIR: SHIELD2.AD10, U4.8
Y_STEP: SHIELD2.AD11, U4.7
Z-MAX: SHIELD2.34, U11.2
Z-MIN: SHIELD2.26, U11.4
Z_DIR: SHIELD2.AD12, U5.8
Z_STEP: SHIELD2.AD13, U5.7
