BiergitKraft/RAMPS-FD/(commit log)

2020-03-24 Inital Commit RAMPS FD v2.3. SPI Support for every Driver added.
    [BoM-RAMPS-FD.ods, Extra_Mosfets.sch, Power.sch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]
2020-06-07 Added UART for Communication with TMC2209 Drivers, improved inverse-polarity protection, added Driver Protection. Two Layer Design
    [Extra_Mosfets.sch, Power.sch, RAMPS-FD.kicad_pcb, RAMPS-FD.sch, con_inputs.sch, con_misc.sch, con_outputs.sch, e-stop.sch]
2020-06-10 Lagenspiegel, minor Silkscreen
    [RAMPS-FD.kicad_pcb]
2020-08-26 V3 Added, UART support for steppers and improved parts/layout
    [BoM-RAMPS-FD.ods, Extra_Mosfets.sch, Power.sch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]
2020-10-14 Bug Notice for Enstop Header
    [con_inputs.sch]
