BiergitKraft/RAMPS-FD/(notices)

Notices in the files:
RAMPS-FD/con_misc.sch:
GPL v3
